30cl/remote-pc-power-on/dummy.config.h

// Wifi settings
#define WIFI_SSID ""
#define WIFI_PASS ""

// Pins
#define POWER_PIN D5
#define RESET_PIN D6
#define STATE_PIN D7

// How long we keep the button pressed (in miliseconds)
#define LONG_PRESS 4500
#define SHORT_PRESS 100
